dansantorojr/eagle-proj/dicio-sensor/DicioWRK.pdf

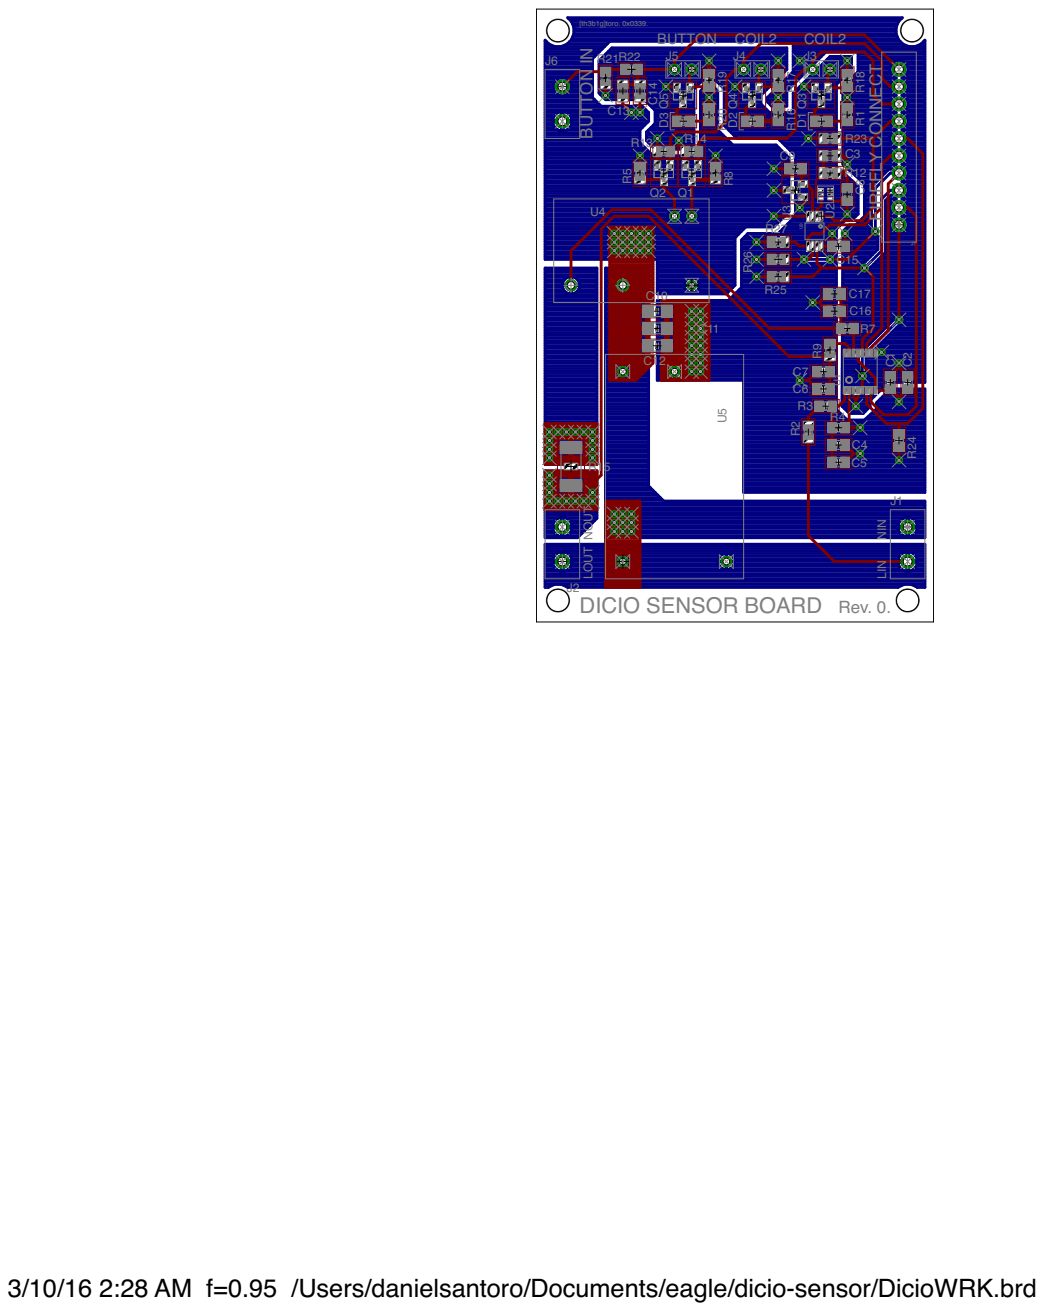
[picture p1: page 1]

DICIO SENSOR BOARD Rev. 0.

3/10/16 2:28 AM f=0.95 /Users/danielsantoro/Documents/eagle/dicio-sensor/DicioWRK.brd
