dansantorojr/eagle-proj/dicio-sensor/BKUP/Dicio.pdf

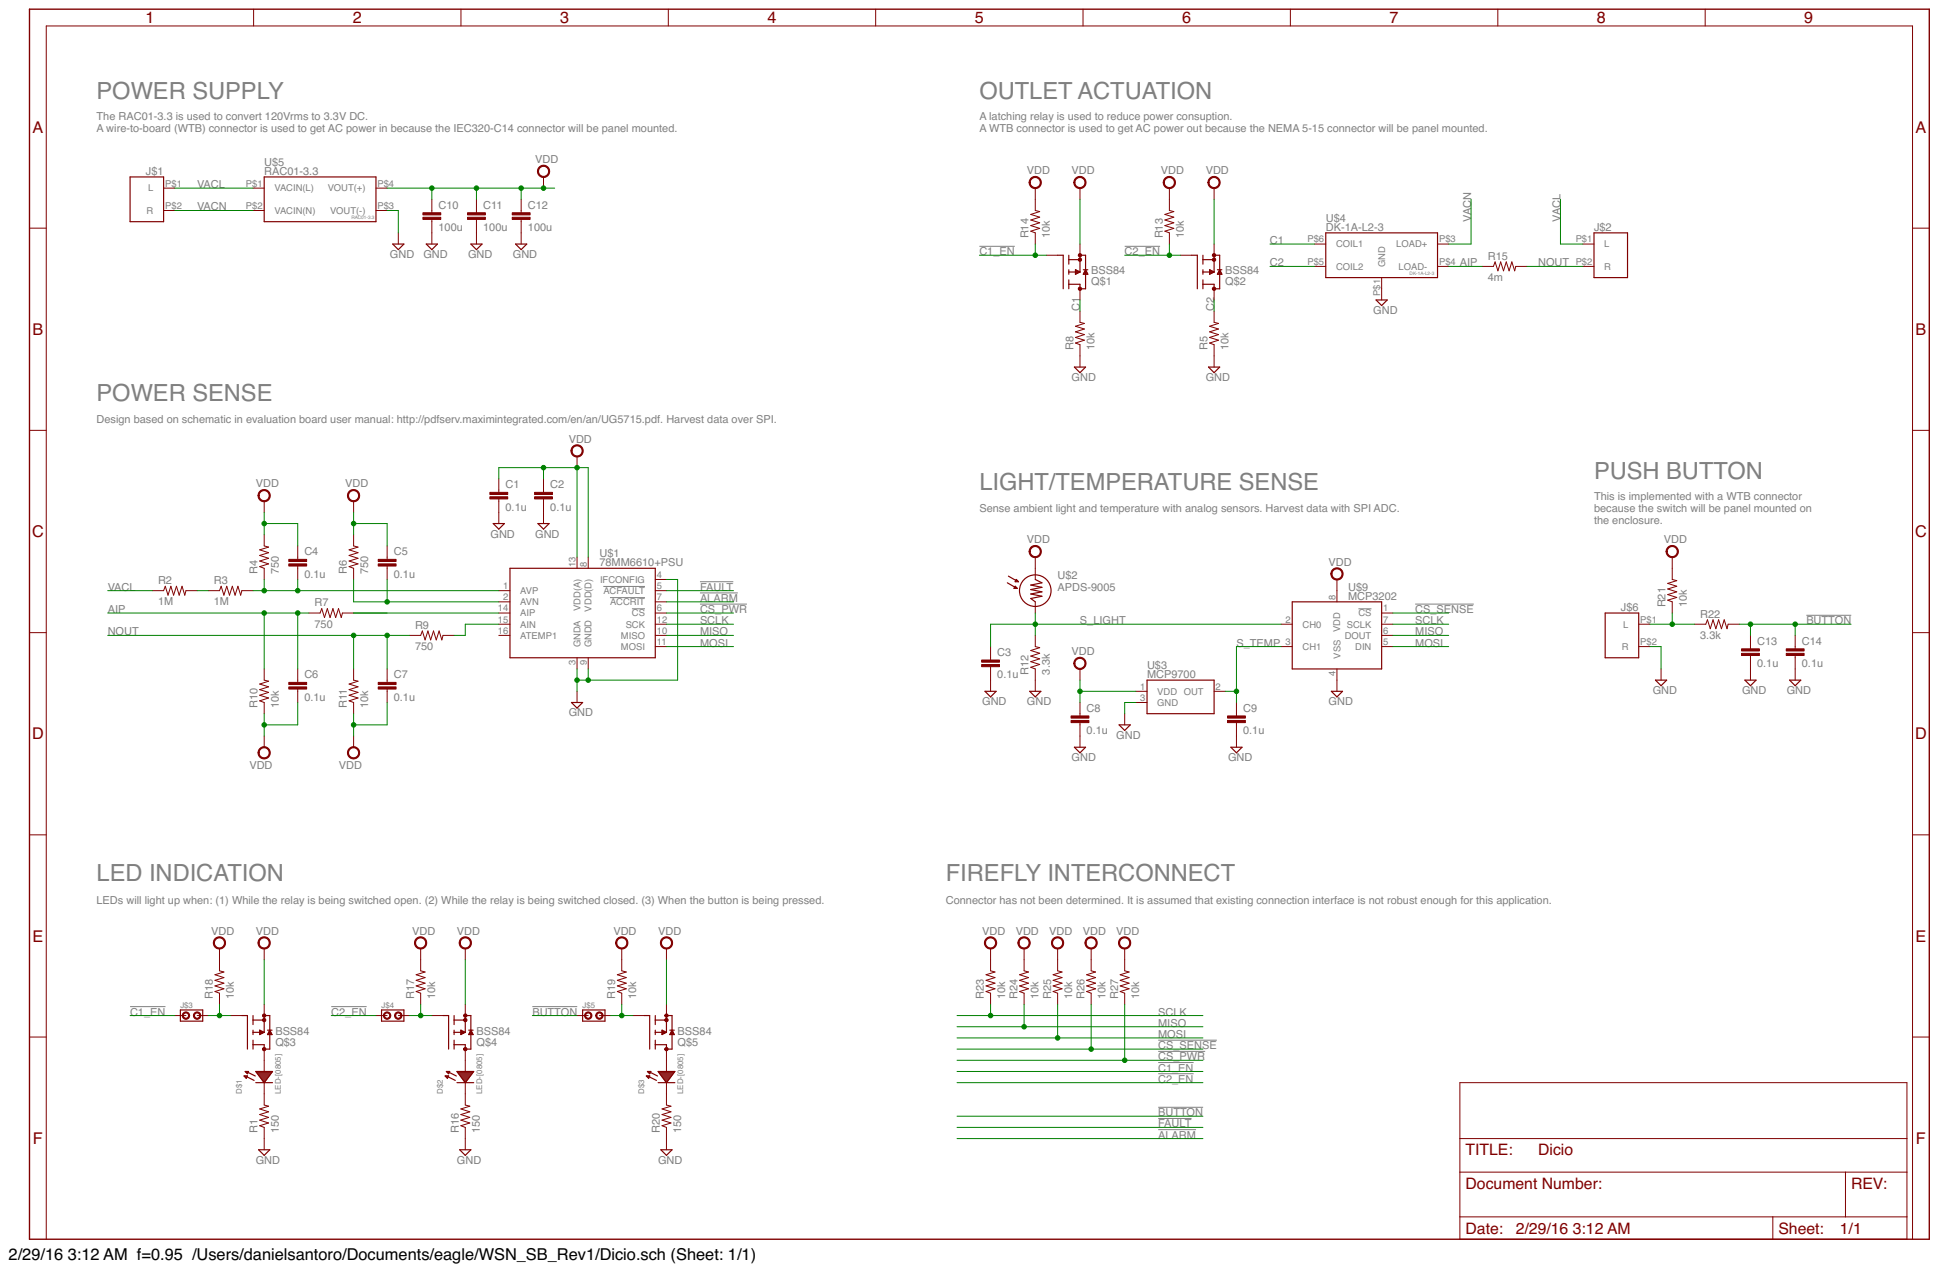
[picture p2: page 1]

The RAC01-3.3 is used to convert 120Vrms to 3.3V DC. A wire-to-board (WTB) connector is used to get AC power in because the IEC320-C14 connector will be panel mounted.

A latching relay is used to reduce power consuption. A WTB connector is used to get AC power out because the NEMA 5-15 connector will be panel mounted.

10k VDD VDD VDD VDD

Design based on schematic in evaluation board user manual: http://pdfserv.maximintegrated.com/en/an/UG5715.pdf. Harvest data over SPI.

This is implemented with a WTB connector because the switch will be panel mounted on

LEDs will light up when: (1) While the relay is being switched open. (2) While the relay is being switched closed. (3) When the button is being pressed.

Connector has not been determined. It is assumed that existing connection interface is not robust enough for this application.

VDD VDD VDD VDD VDD

Document Number: | REV:

Date: 2/29/16 3:12 AM | Sheet: 1/1

2/29/16 3:12 AM f=0.95 /Users/danielsantoro/Documents/eagle/WSN_SB_Rev1/Dicio.sch (Sheet: 1/1)
