dansantorojr/eagle-proj/dicio-sensor/DicioWRK.brd

## EAGLE design dicio-sensor/DicioWRK.brd (2016-04-05)

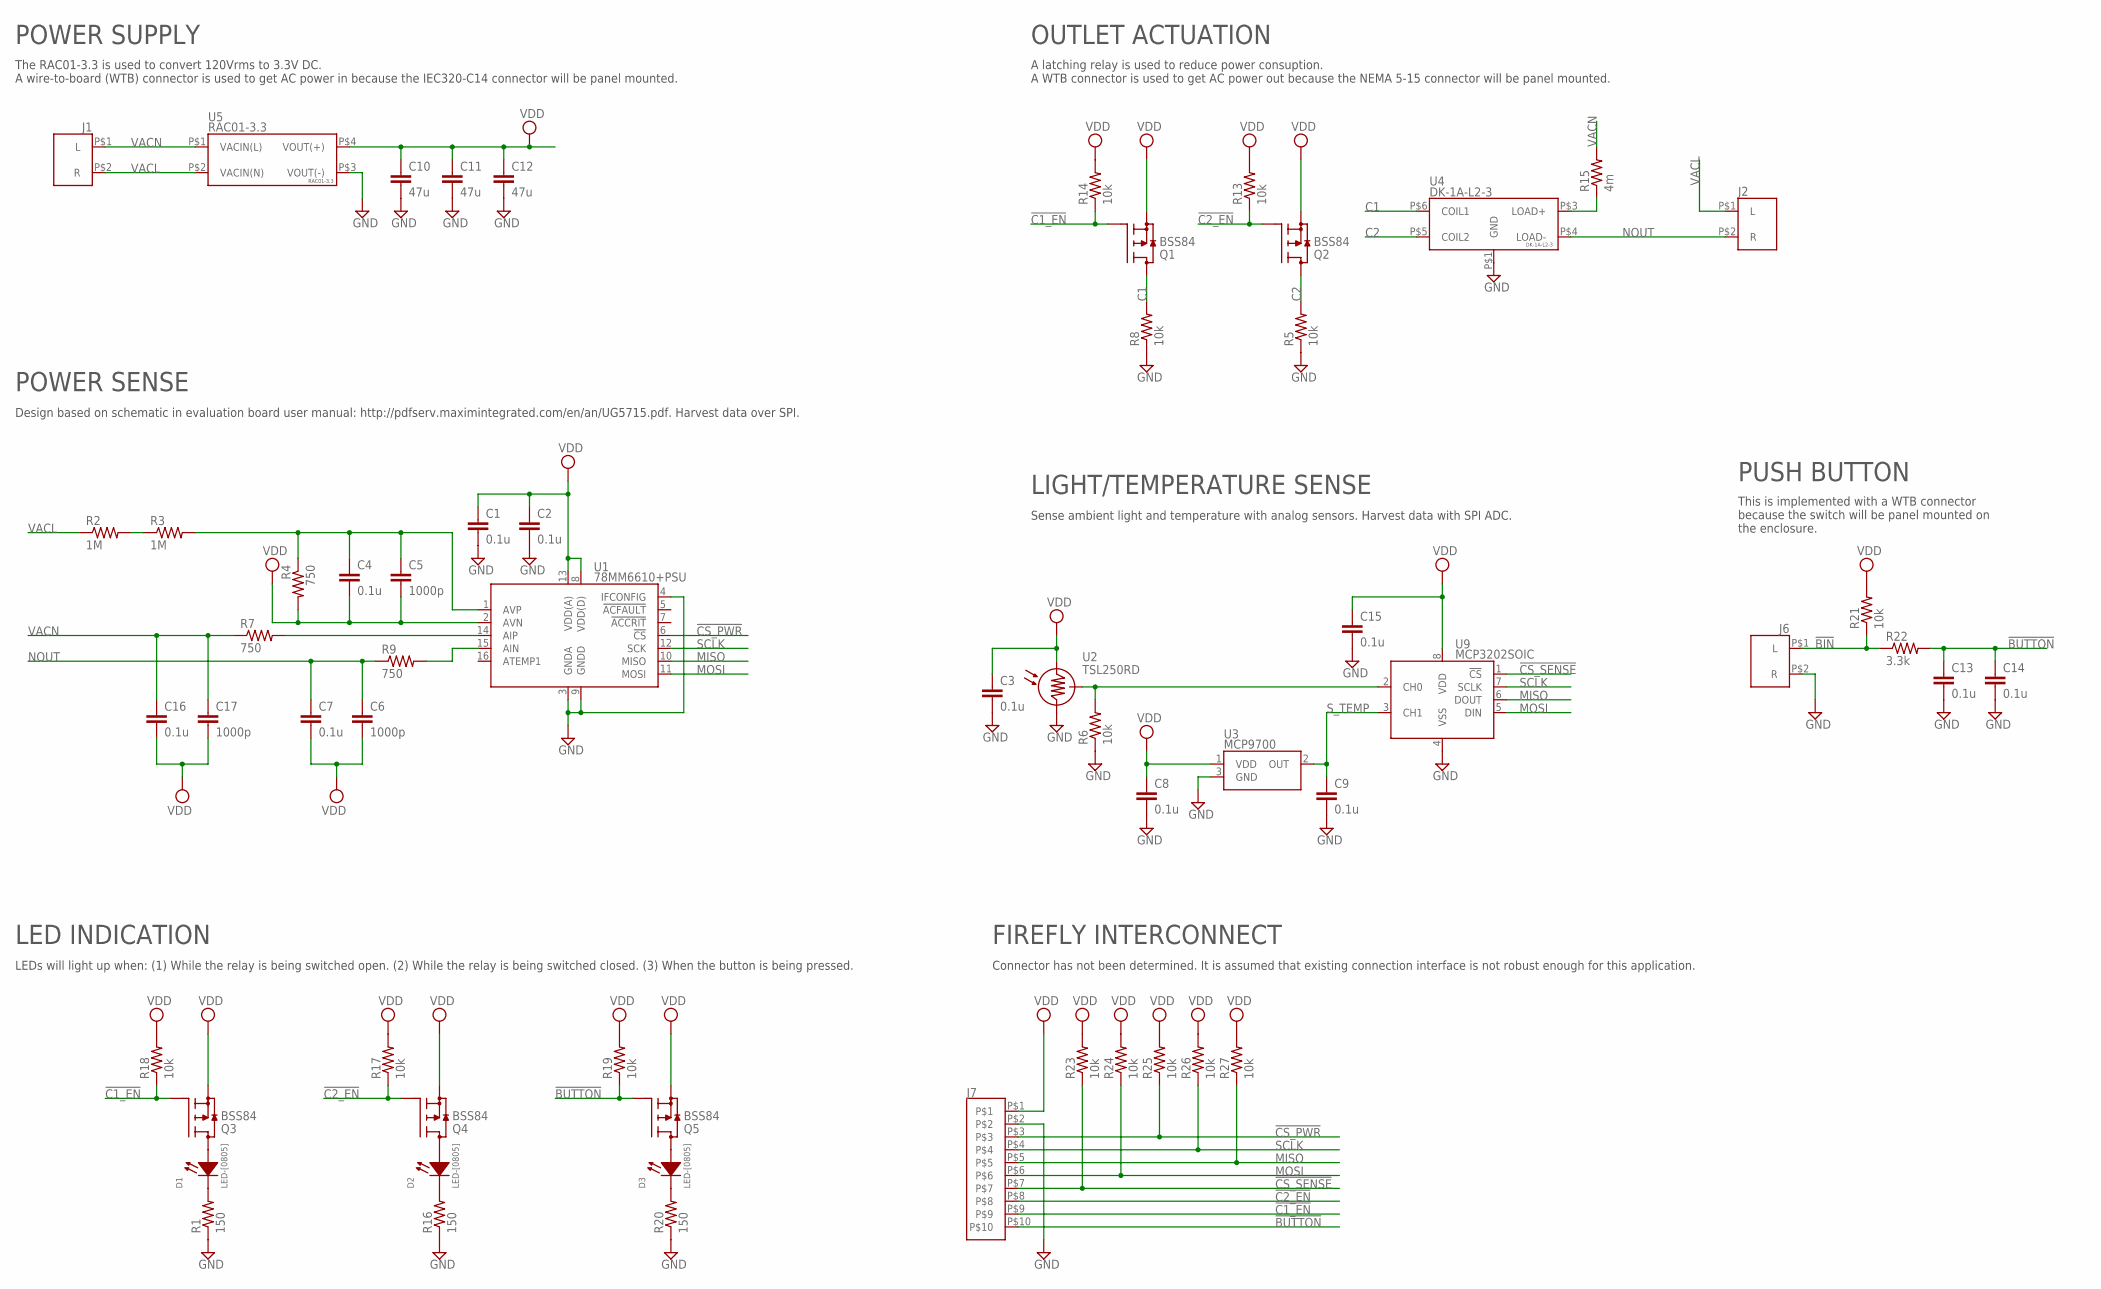
[picture p3: schematic DicioWRK.sch]

Parts:
C1, C2, C3, C4, C7, C8, C9, C13, C14, C15, C16: 0.1u; C0805
C5, C6, C17: 1000p; C0805
C10, C11, C12: 47u; C1206
D1, D2, D3: LED-[0805]; L0805
J1, J2, J6: WTB-2; [TERM][2][0.2]
J7: TERM10
Q1, Q2, Q3, Q4, Q5: BSS84; SOT23
R1, R16, R20: 150; R0805
R2, R3: 1M; R0805
R4, R7, R9: 750; R0805
R5, R6, R8, R13, R14, R17, R18, R19, R21, R23, R24, R25, R26, R27: 10k; R0805
R15: 4m; R2512
R22: 3.3k; R0805
U1: 78MM6610+PSU; TSSOP16
U2: TSL250RD; SOIC8
U3: MCP9700; SOT23
U4: DK-1A-L2-3
U5: RAC01-3.3
U9: MCP3202SOIC; SOIC8

Connections:
!BIN!: J6.P$1 (L), R21.1, R22.1
!BUTTON!: C13.1, C14.1, J7.P$10, Q5.1 (G), R19.1, R22.2
!C1_EN!: J7.P$9, Q1.1 (G), Q3.1 (G), R14.1, R18.1
!C2_EN!: J7.P$8, Q2.1 (G), Q4.1 (G), R13.1, R17.1
!CS_PWR!: J7.P$3, R25.1, U1.6 (!CS!)
!CS_SENSE!: J7.P$7, R23.1, U9.1 (!CS!)
C1: Q1.3 (D), R8.2, U4.P$6 (COIL1)
C2: Q2.3 (D), R5.2, U4.P$5 (COIL2)
GND: C1.2, C2.2, C3.2, C8.2, C9.2, C10.2, C11.2, C12.2, C13.2, C14.2, C15.2, J6.P$2 (R), J7.P$2, R1.1, R5.1, R6.1, R8.1, R16.1, R20.1, U1.3 (GNDA), U1.4 (IFCONFIG), U1.9 (GNDD), U2.4 (GND), U3.3 (GND), U4.P$1 (GND), U5.P$3 (VOUT(-)), U9.4 (VSS)
MISO: J7.P$5, R27.1, U1.10 (MISO), U9.6 (DOUT)
MOSI: J7.P$6, R24.1, U1.11 (MOSI), U9.5 (DIN)
unnamed: C4.1, C5.1, R3.2, R4.1, U1.1 (AVP)
unnamed: R2.2, R3.1
unnamed: D2.1 (A), Q4.3 (D)
unnamed: R6.2, U2.7 (OUT), U9.2 (CH0)
unnamed: D1.1 (A), Q3.3 (D)
unnamed: R15.1, U4.P$3 (LOAD+)
unnamed: D1.2 (C), R1.2
unnamed: D2.2 (C), R16.2
unnamed: D3.1 (A), Q5.3 (D)
unnamed: D3.2 (C), R20.2
unnamed: R7.2, U1.14 (AIP)
unnamed: R9.2, U1.15 (AIN)
NOUT: C6.1, C7.1, J2.P$2 (R), R9.1, U4.P$4 (LOAD-)
SCLK: J7.P$4, R26.1, U1.12 (SCK), U9.7 (SCLK)
S_TEMP: C9.1, U3.2 (OUT), U9.3 (CH1)
VACL: J1.P$2 (R), J2.P$1 (L), R2.1, U5.P$2 (VACIN(N))
VACN: C16.1, C17.1, J1.P$1 (L), R7.1, R15.2, U5.P$1 (VACIN(L))
VDD: C1.1, C2.1, C3.1, C4.2, C5.2, C6.2, C7.2, C8.1, C10.1, C11.1, C12.1, C15.1, C16.2, C17.2, J7.P$1, Q1.2 (S), Q2.2 (S), Q3.2 (S), Q4.2 (S), Q5.2 (S), R4.2, R13.2, R14.2, R17.2, R18.2, R19.2, R21.2, R23.2, R24.2, R25.2, R26.2, R27.2, U1.2 (AVN), U1.8 (VDD(D)), U1.13 (VDD(A)), U2.6 (VDD), U3.1 (VDD), U5.P$4 (VOUT(+)), U9.8 (VDD)

Notes on the sheet:
POWER SUPPLY
OUTLET ACTUATION
POWER SENSE
LIGHT/TEMPERATURE SENSE
LED INDICATION
Design based on schematic in evaluation board user manual: http://pdfserv.maximintegrated.com/en/an/UG5715.pdf. Harvest data over SPI.
The RAC01-3.3 is used to convert 120Vrms to 3.3V DC. A wire-to-board (WTB) connector is used to get AC power in because the IEC320-C14 connector will be panel mounted.
LEDs will light up when: (1) While the relay is being switched open. (2) While the relay is being switched closed. (3) When the button is being pressed.
A latching relay is used to reduce power consuption. A WTB connector is used to get AC power out because the NEMA 5-15 connector will be panel mounted.
Sense ambient light and temperature with analog sensors. Harvest data with SPI ADC.
PUSH BUTTON
This is implemented with a WTB connector because the switch will be panel mounted on the enclosure.
FIREFLY INTERCONNECT
Connector has not been determined. It is assumed that existing connection interface is not robust enough for this application.

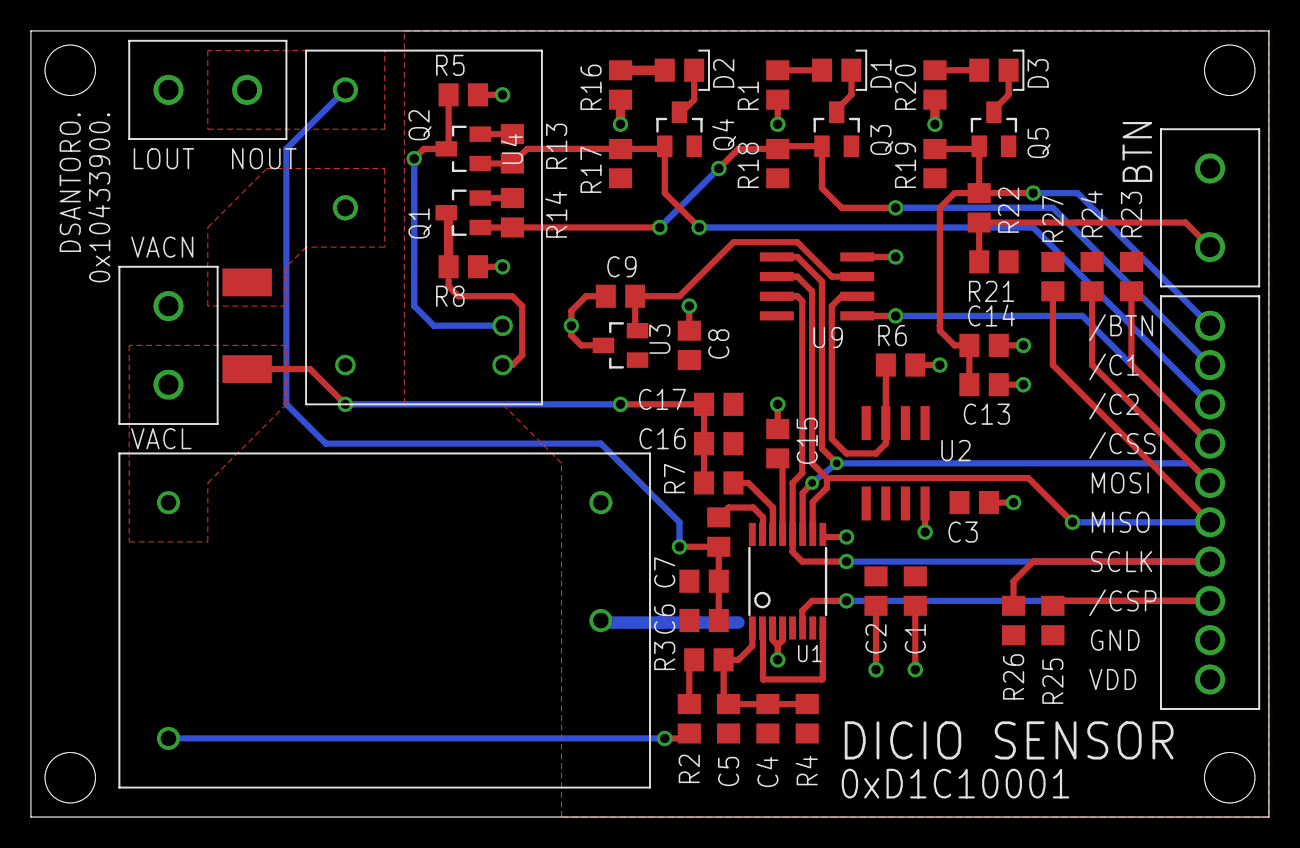
[picture p4: board DicioWRK.brd from above]

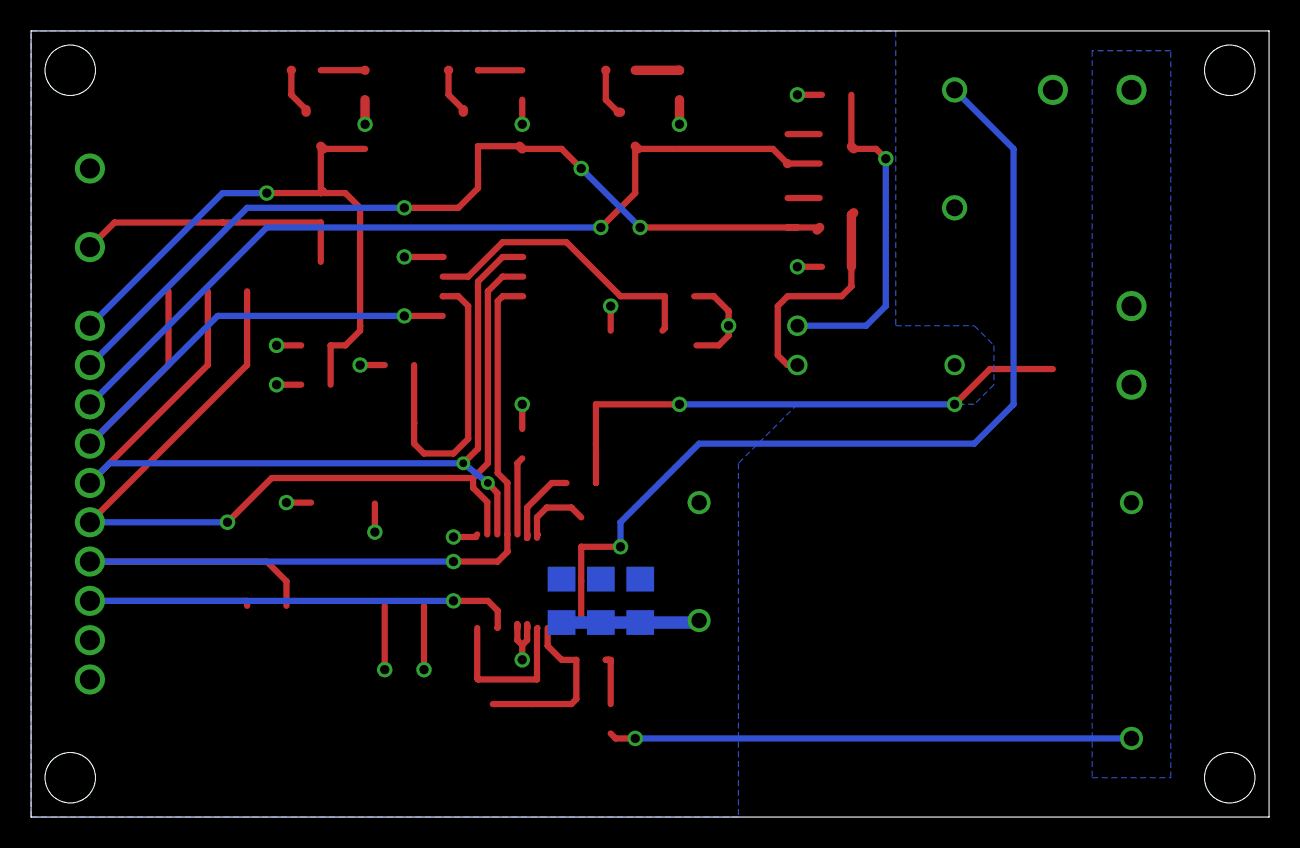
[picture p5: board DicioWRK.brd from below]

Board: 2 copper layers, 80.0 x 50.8 mm, 59 parts (3 on the bottom side), 29 nets.
