dansantorojr/eagle-proj/dicio-interconnect/Inter.brd

## EAGLE design dicio-interconnect/Inter.brd (2016-04-02)

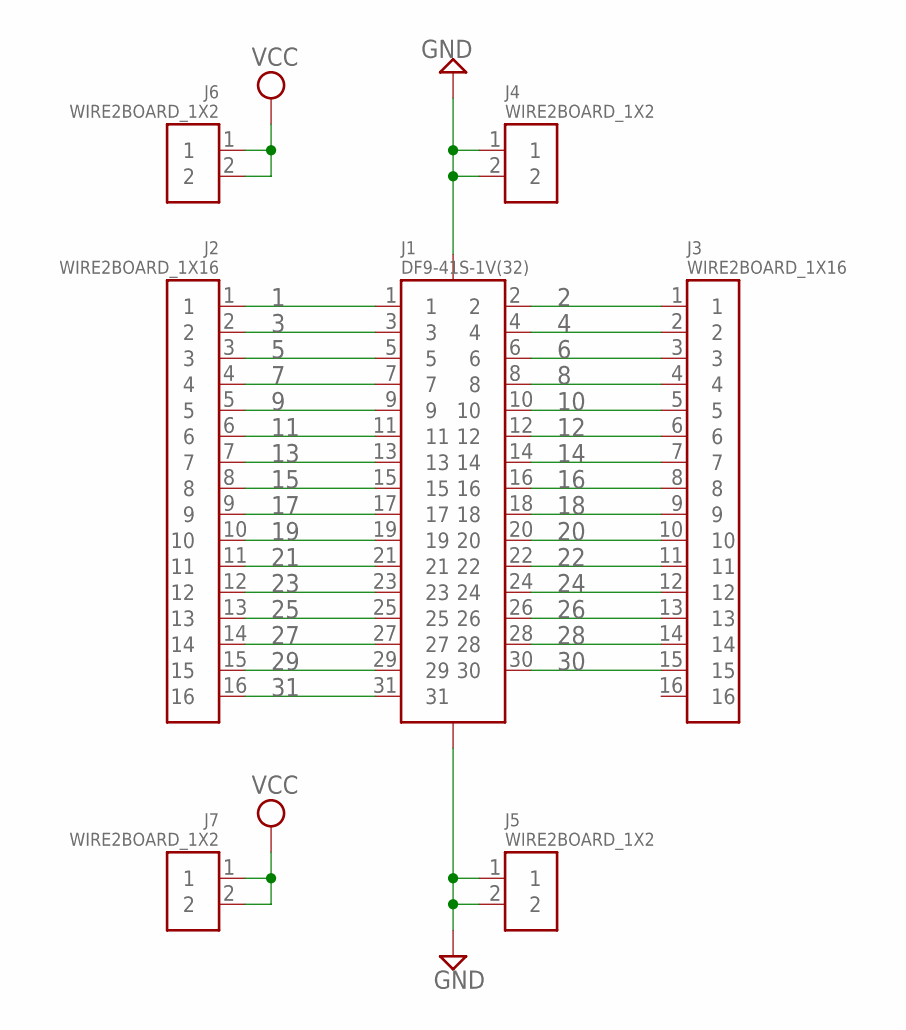
[picture p6: schematic Inter.sch]

Parts:
J1: DF9-41S-1V(32)
J2, J3: WIRE2BOARD_1X16
J4, J5, J6, J7: WIRE2BOARD_1X2

Connections:
1: J1.1, J2.1
2: J1.2, J3.1
3: J1.3, J2.2
4: J1.4, J3.2
5: J1.5, J2.3
6: J1.6, J3.3
7: J1.7, J2.4
8: J1.8, J3.4
9: J1.9, J2.5
10: J1.10, J3.5
11: J1.11, J2.6
12: J1.12, J3.6
13: J1.13, J2.7
14: J1.14, J3.7
15: J1.15, J2.8
16: J1.16, J3.8
17: J1.17, J2.9
18: J1.18, J3.9
19: J1.19, J2.10
20: J1.20, J3.10
21: J1.21, J2.11
22: J1.22, J3.11
23: J1.23, J2.12
24: J1.24, J3.12
25: J1.25, J2.13
26: J1.26, J3.13
27: J1.27, J2.14
28: J1.28, J3.14
29: J1.29, J2.15
30: J1.30, J3.15
31: J1.31, J2.16
GND: J1.32, J1.33, J4.1, J4.2, J5.1, J5.2
VCC: J6.1, J6.2, J7.1, J7.2

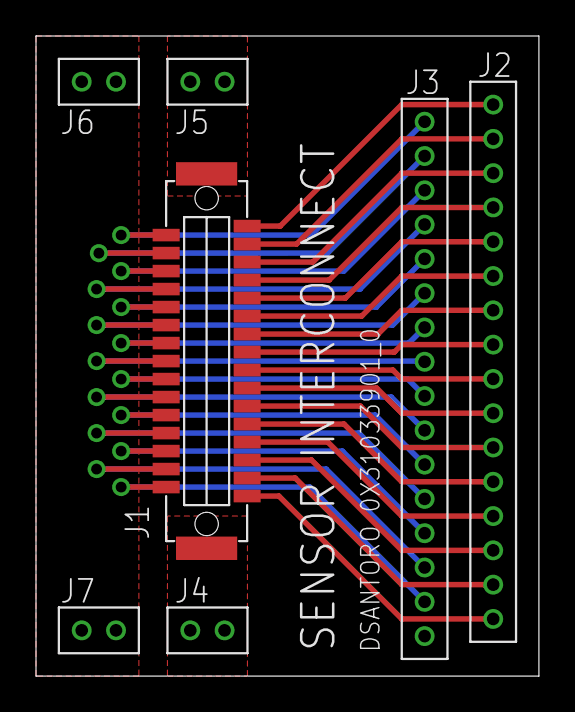
[picture p7: board Inter.brd from above]

Board: 2 copper layers, 27.9 x 35.6 mm, 7 parts (0 on the bottom side), 33 nets.
