dansantorojr/eagle-proj/(commit log)

2016-04-03 Working on Rev. 2.
    [DicioWRK.brd, DicioWRK.sch]
2016-04-04 Dicio sensor Rev 1
    [DicioWRK.brd, DicioWRK.sch]
2016-04-05 R1-Out for Fab.
    [DicioWRK.brd, DicioWRK.sch]
